ironmann250/4-DOF-autonomous-robotic-arm-picker/README.md

# 4 DOF autonomous robotic arm picker
 a robotic arm that picks objects autonomously, it uses an arduino micro and esp32-cam
 robot picking object
