ironmann250/4-DOF-autonomous-robotic-arm-picker/cad/gripper/Robotic_Arm_Palm.stl

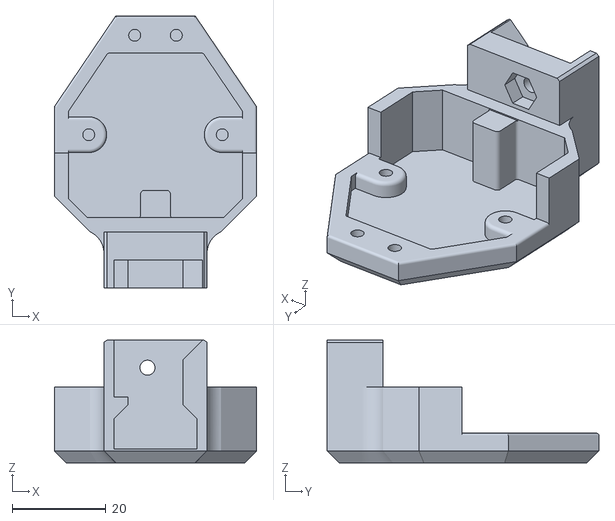
[picture p9: CAD file, 2022-06-11]
cad/gripper/Robotic_Arm_Palm.stl
43.2 x 58.0 x 26.2
