ironmann250/4-DOF-autonomous-robotic-arm-picker/cad/upperBaseServoMount.SLDPRT

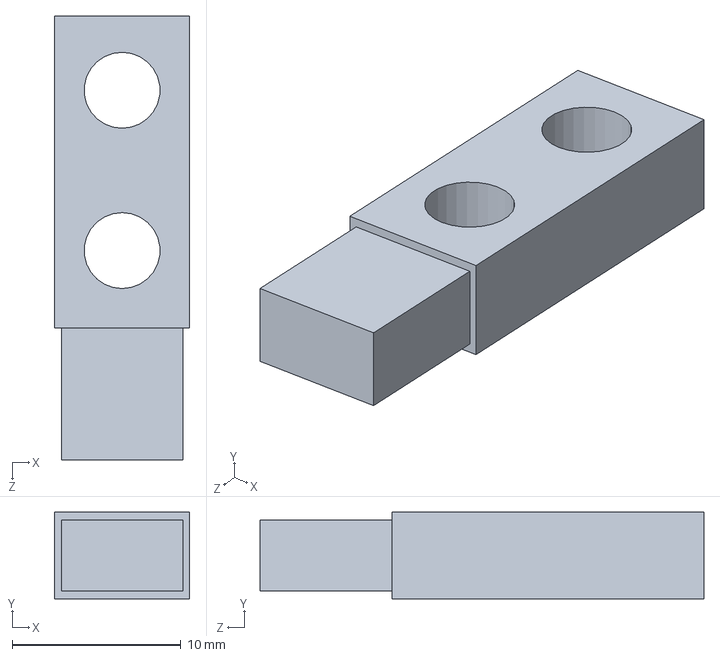
[picture p10: CAD file, 2022-06-11]
cad/upperBaseServoMount.SLDPRT
8.00 x 5.14 x 26.3 mm
