ironmann250/4-DOF-autonomous-robotic-arm-picker/cad/gripper/Robotic_Arm_Finger.stl

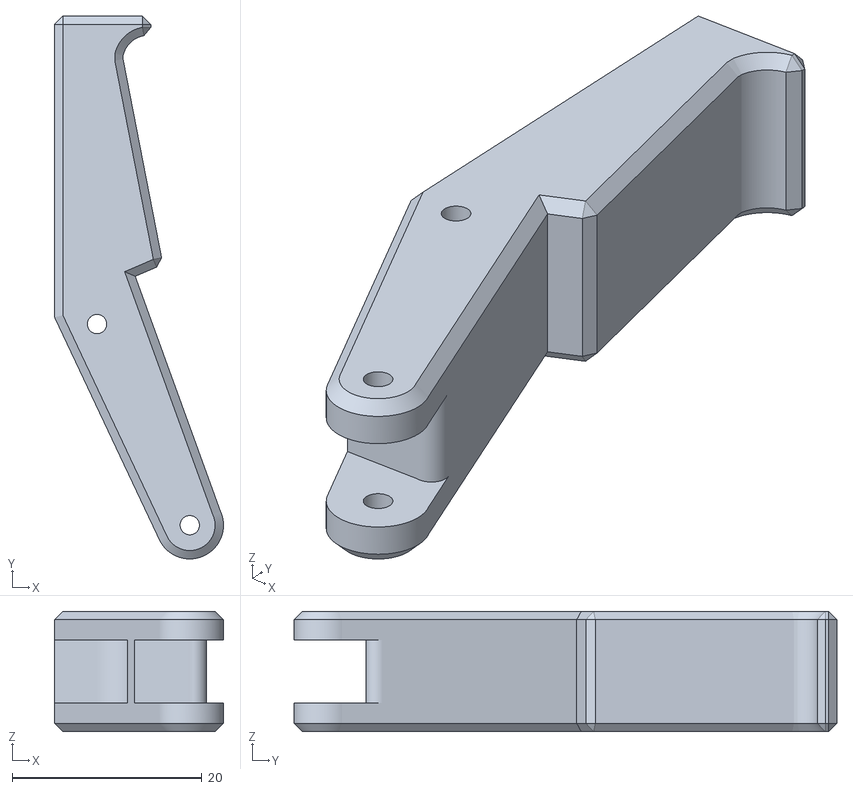
[picture p11: CAD file, 2022-06-11]
cad/gripper/Robotic_Arm_Finger.stl
17.8 x 57.2 x 12.7
