ironmann250/4-DOF-autonomous-robotic-arm-picker/cad/upperArmtest.STL

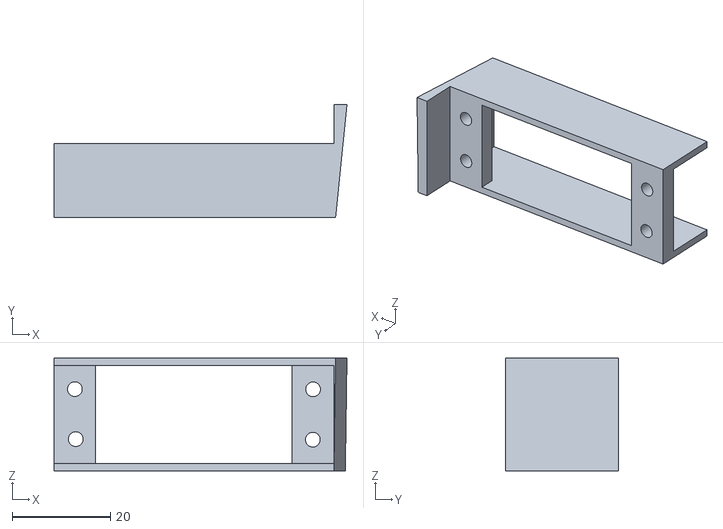
[picture p12: CAD file, 2022-06-11]
cad/upperArmtest.STL
59.7 x 23.0 x 23.0
