ironmann250/4-DOF-autonomous-robotic-arm-picker/cad/base.SLDPRT

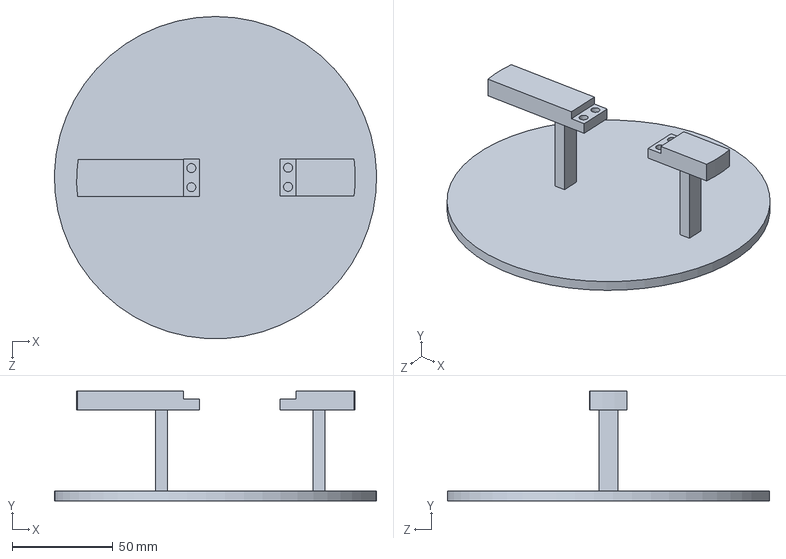
[picture p13: CAD file, 2022-06-11]
cad/base.SLDPRT
159.9 x 54.5 x 159.9 mm
