ironmann250/4-DOF-autonomous-robotic-arm-picker/cad/gripper/Robotic_Arm_Forward_Hinge_Arm.stl

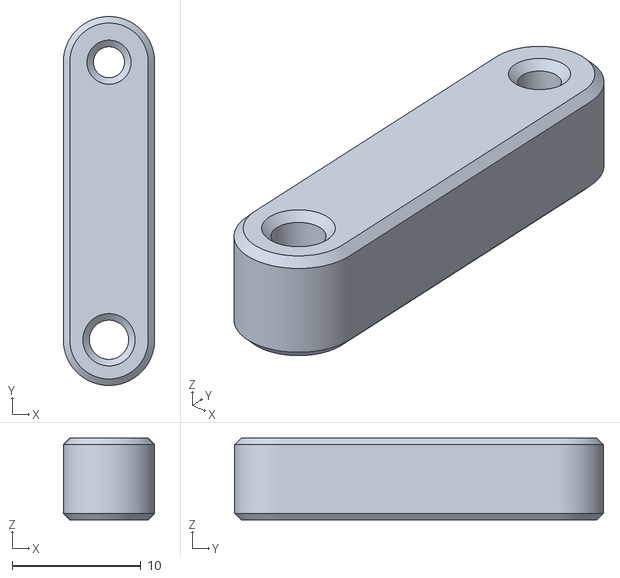
[picture p14: CAD file, 2022-06-11]
cad/gripper/Robotic_Arm_Forward_Hinge_Arm.stl
7.11 x 28.7 x 6.35
