ironmann250/4-DOF-autonomous-robotic-arm-picker/cad/gripper/Robotic_Arm_Gear_Arm_Right.stl

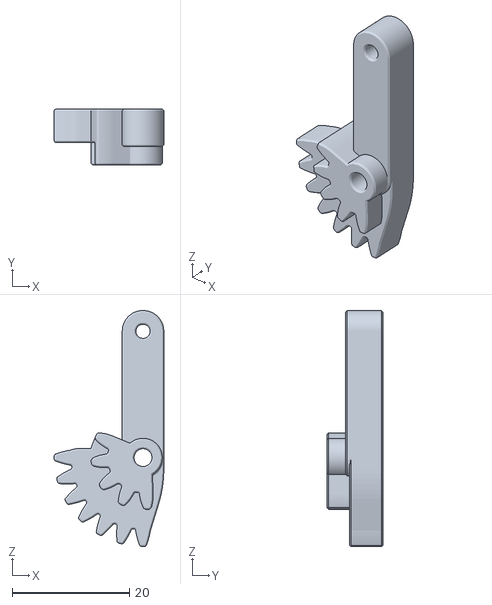
[picture p15: CAD file, 2022-06-11]
cad/gripper/Robotic_Arm_Gear_Arm_Right.stl
18.7 x 9.53 x 40.3
