ironmann250/4-DOF-autonomous-robotic-arm-picker/cad/lowerArm.SLDPRT

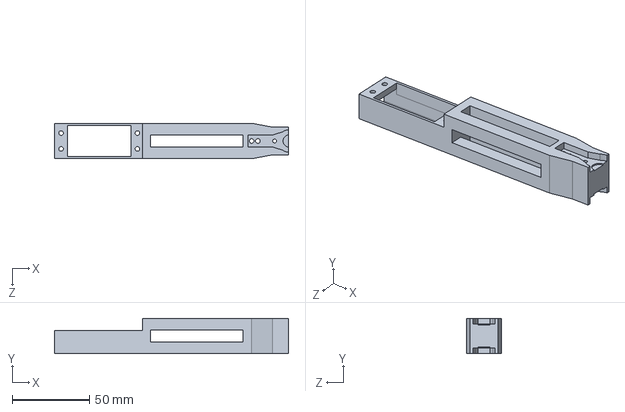
[picture p16: CAD file, 2022-06-11]
cad/lowerArm.SLDPRT
151.7 x 23.0 x 23.0 mm
