ironmann250/4-DOF-autonomous-robotic-arm-picker/cad/baseOptimized.SLDPRT

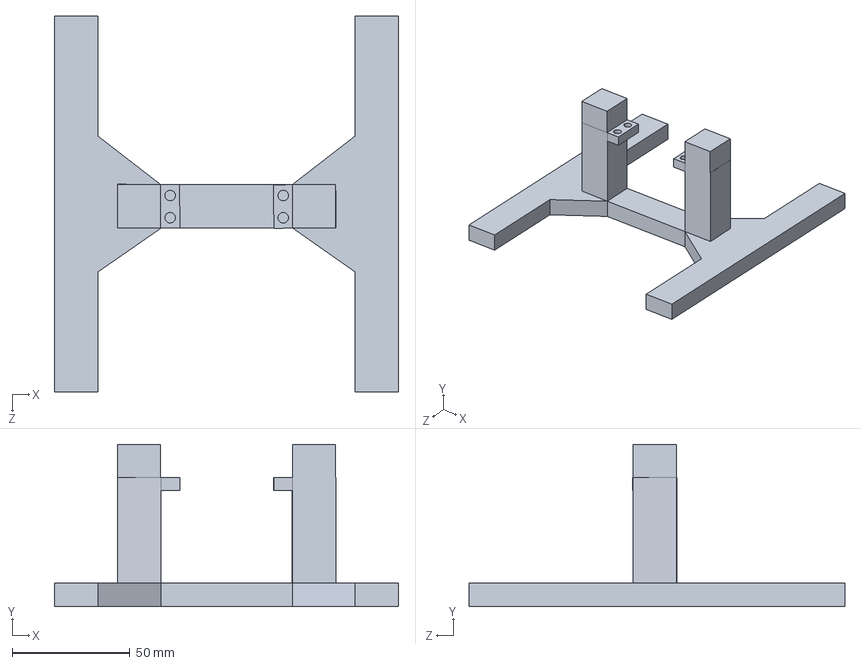
[picture p17: CAD file, 2022-06-11]
cad/baseOptimized.SLDPRT
146.4 x 69.0 x 160.0 mm
