ironmann250/4-DOF-autonomous-robotic-arm-picker/cad/gripper/Robotic_Arm_Finger_Pad.stl

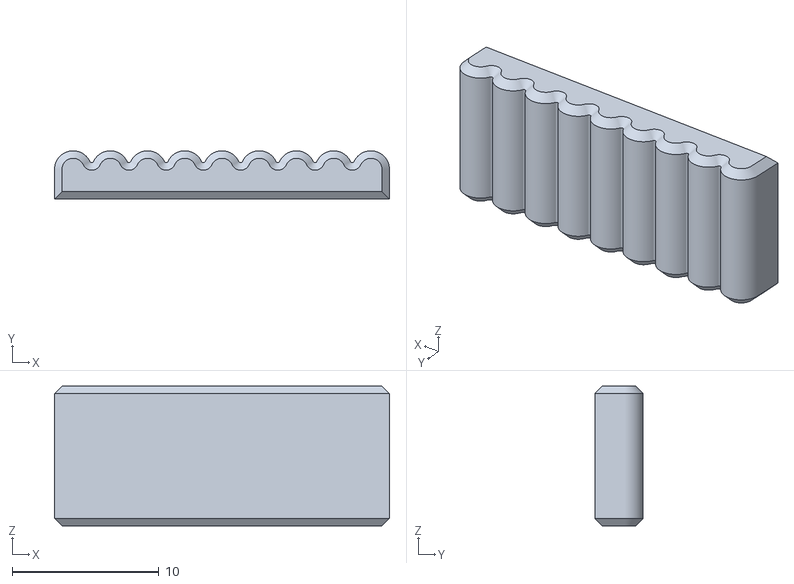
[picture p18: CAD file, 2022-06-11]
cad/gripper/Robotic_Arm_Finger_Pad.stl
22.9 x 3.30 x 9.53
