ironmann250/4-DOF-autonomous-robotic-arm-picker/cad/gripper/Robotic_Arm_Gear_Arm_Left.stl

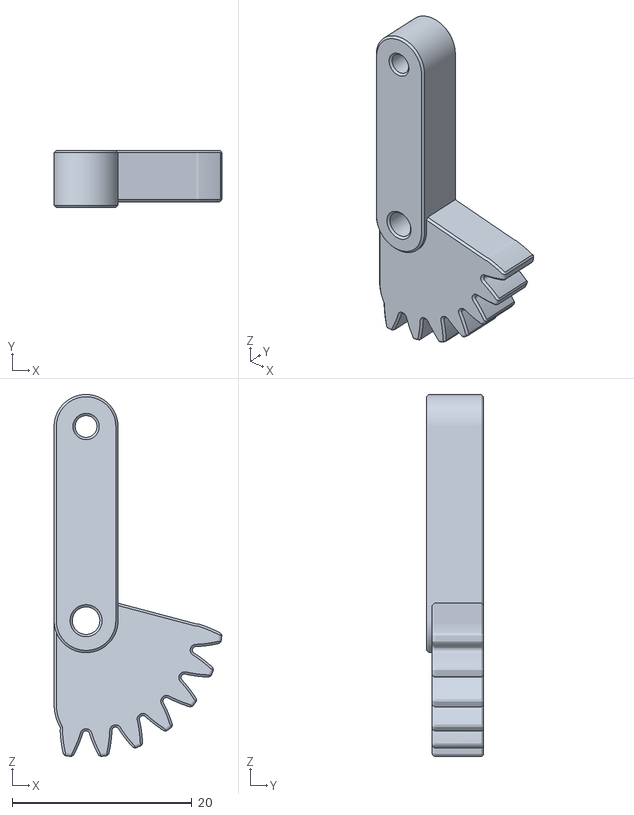
[picture p19: CAD file, 2022-06-11]
cad/gripper/Robotic_Arm_Gear_Arm_Left.stl
18.7 x 6.35 x 40.2
