ironmann250/4-DOF-autonomous-robotic-arm-picker/cad/upperArm.SLDPRT

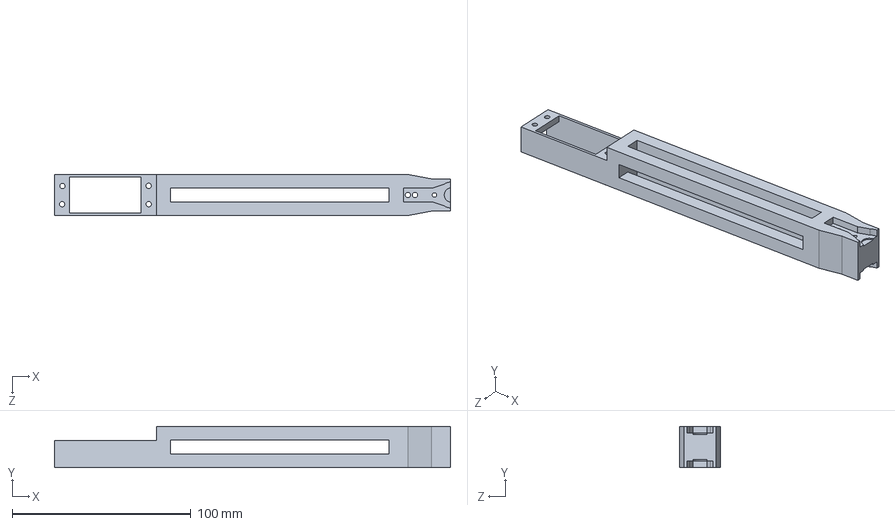
[picture p20: CAD file, 2022-06-11]
cad/upperArm.SLDPRT
221.7 x 23.0 x 23.0 mm
