ironmann250/4-DOF-autonomous-robotic-arm-picker/cad/gripper holder.SLDPRT

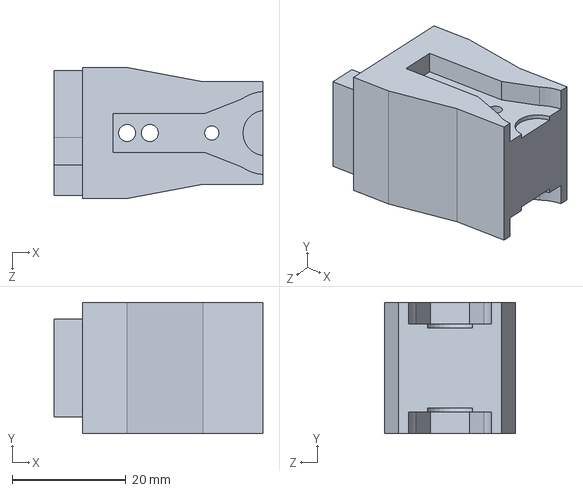
[picture p21: CAD file, 2022-06-11]
cad/gripper holder.SLDPRT
36.7 x 23.0 x 23.0 mm
