ironmann250/4-DOF-autonomous-robotic-arm-picker/cad/gripper/Robotic_Arm_Servo_Gear.stl

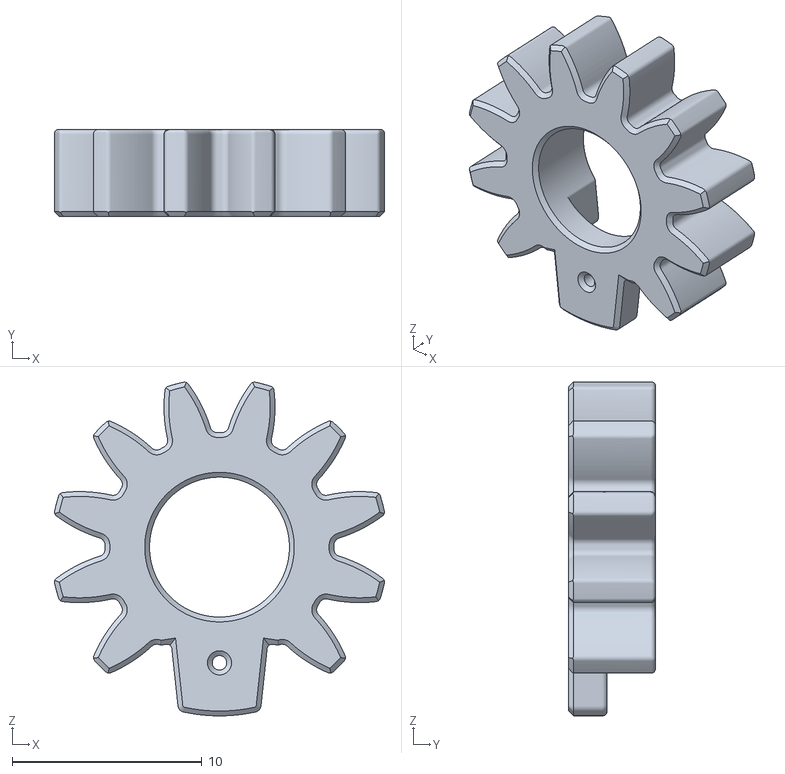
[picture p22: CAD file, 2022-06-11]
cad/gripper/Robotic_Arm_Servo_Gear.stl
17.4 x 4.57 x 17.6
