ironmann250/4-DOF-autonomous-robotic-arm-picker/cad/gripper/AI3MSPRO_Robotic_gripper.3mf

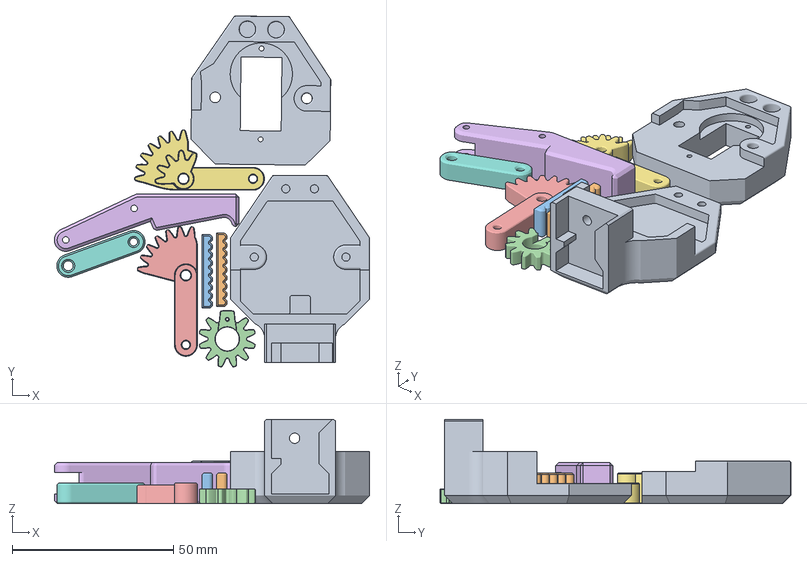
[picture p23: CAD file, 2022-06-11]
cad/gripper/AI3MSPRO_Robotic_gripper.3mf
97.9 x 108.9 x 26.2 mm
Robotic_Arm_Palm.stl
Robotic_Arm_Finger_Pad.stl
Robotic_Arm_Finger_Pad.stl(1)
Robotic_Arm_Servo_Gear.stl
Robotic_Arm_Gear_Arm_Left.stl
Robotic_Arm_Finger.stl
Robotic_Arm_Gear_Arm_Right.stl
Robotic_Arm_Forward_Hinge_Arm.stl
Robotic_Arm_Palm_Top.stl
