ironmann250/4-DOF-autonomous-robotic-arm-picker/cad/upperBase.SLDPRT

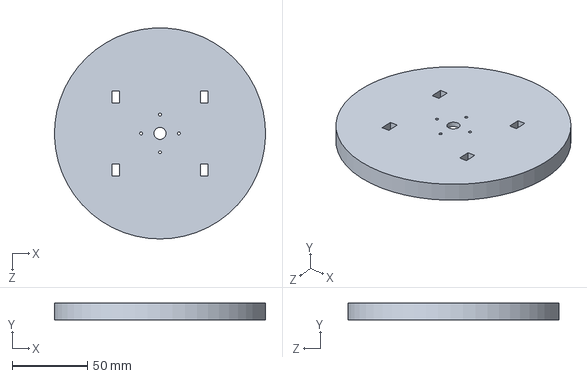
[picture p24: CAD file, 2022-06-11]
cad/upperBase.SLDPRT
139.9 x 11.0 x 139.9 mm
