ironmann250/4-DOF-autonomous-robotic-arm-picker/cad/gripper/Robotic_Arm_Palm_Top.stl

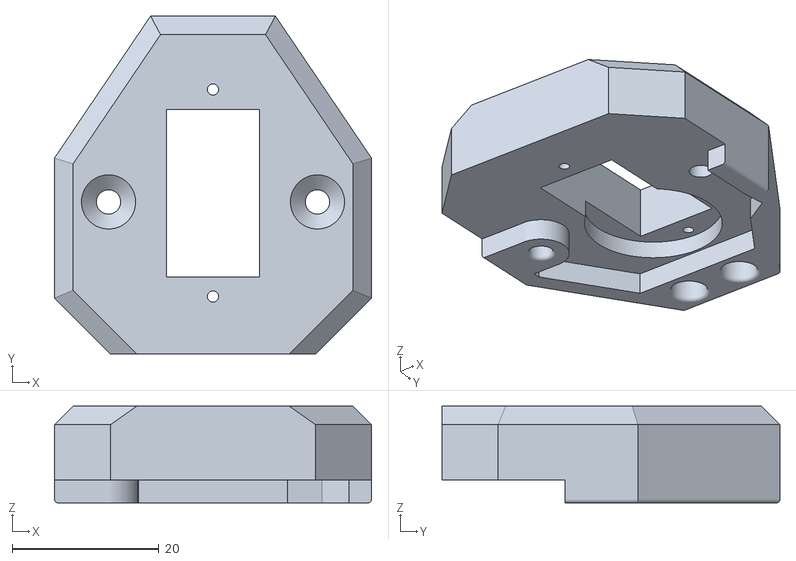
[picture p25: CAD file, 2022-06-11]
cad/gripper/Robotic_Arm_Palm_Top.stl
43.2 x 46.0 x 13.2
