ironmann250/4-DOF-autonomous-robotic-arm-picker/cad/hornholdertest.SLDPRT

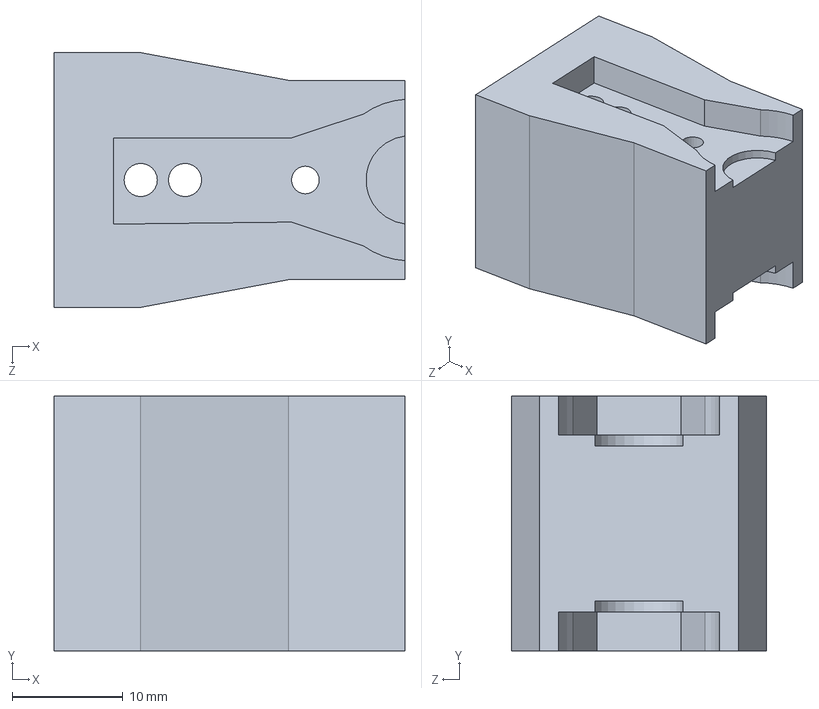
[picture p26: CAD file, 2022-06-11]
cad/hornholdertest.SLDPRT
31.7 x 23.0 x 23.0 mm
