ironmann250/4-DOF-autonomous-robotic-arm-picker/cad/test_grip_holder.stl

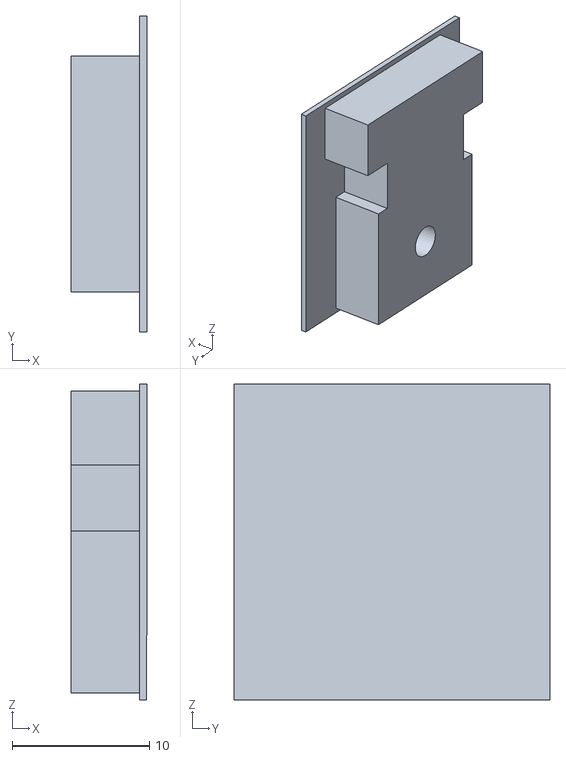
[picture p27: CAD file, 2022-06-11]
cad/test_grip_holder.stl
5.53 x 23.0 x 23.0
