ironmann250/4-DOF-autonomous-robotic-arm-picker/(list of files, cad)

Other CAD files:
cad/upperArmLighter.STL
cad/base.STL
cad/baseOptimized.STL
cad/gripper holder.STL
cad/hornholdertest.STL
cad/lowerArm.STL
cad/upperArm.STL
cad/upperBase.STL
cad/upperBaseServoMount.STL
